msk-610/ReflowOven/doc/reflow_BOM.pdf

Num. | Ref | Value | Characteristics | Q'TY | Footprint | Vendor | Model Name
1 BZ1 | | UDB-05LFPN | Buzzer | 1 | 12x9.5RM7.6 | DB Products Limited. | UDB-05LFPN (https://akizukidenshi.com/catalog/g/gP-09704/)
2 C11 | | 0.01uF | 50V/B | 1 | 1608 | Murata | GRM188B11H103KA01 (https://akizukidenshi.com/catalog/g/gP-13387/)
3 C6,C8,C12,C13 | | 0.1uF | 50V/X8L | 4 | 1608 | Murata | GCM188L81H104K57 (https://akizukidenshi.com/catalog/g/gP-16143/)
4 C3 | | 1uF | 25V/X7R | 1 | 1608 | Murata | GRM188R71E105KA12 (https://akizukidenshi.com/catalog/g/gP-14526/)
5 C1,C9 | | 10uF | 16V/X5R | 2 | 1608 | Murata | GRM188R61C106KAAL (https://akizukidenshi.com/catalog/g/gP-17202/)
6 C4,C5,C10 | | 22uF | 25V/X5R | 3 | 2012 | Murata | GRM21BR61E226ME44 (https://akizukidenshi.com/catalog/g/gP-08240/)
7 C2,C7 | | 100uF/16V | 105℃ | 2 | Radial_D6.3mm_P2.50mm_H5.0mm | ルビコン | 16MH5100MEFC6.3X5 (https://akizukidenshi.com/catalog/g/gP-05002/)
8 D1 | | BAT43XV2 | Schottky Barrier Diode | 1 | SOD-523 | ON Semiconductor | BAT43XV2 (https://akizukidenshi.com/catalog/g/gI-06467/)
9 FB1,FB2,FB3,FB4 | | BLM18PG121SN1D | 120Ω/2A | 4 | 1608 | Murata | BLM18PG121SN1D (https://akizukidenshi.com/catalog/g/gP-10766/)
10 J1 | | S2B-PH-K-S | | 1 | S2B-PH-K | 日本圧着端子 | S2B-PH-K-S(LF)(SN) (https://akizukidenshi.com/catalog/g/gC-12633/)
11 J2 | | Conn_02x03 | PinHeader | 1 | 2x03_P2.54mm_Horizontal | Useconn Electronics Ltd. | PH-2x40RG (https://akizukidenshi.com/catalog/g/gC-00148/)
12 J3 | | S10B-PH-K-S | | 1 | S10B-PH-K | 日本圧着端子 | S10B-PH-K-S(LF)(SN) (https://www.sengoku.co.jp/mod/sgk_cart/detail.php?code=EEHD-55FJ)
13 J4 | | FH-1x14SG | PinSocket | 1 | 1x14_P2.54mm_Vertical | Useconn Electronics Ltd. | FH-1x14SG (https://akizukidenshi.com/catalog/g/gC-00653/)
14 J5 | | PCC_SMP | | 1 | PCC-SMP-K | オメガエンジニアリング | PCC-SMP-K-ROHS (https://akizukidenshi.com/catalog/g/gP-14972/)
15 Q1,Q2,Q3 | | AO3400A | Nch MOSFET | 3 | SOT-23 | Alpha & Omega Semiconductor | AO3400A (https://akizukidenshi.com/catalog/g/gI-14653/)
16 R13,R14 | | 0 | | 2 | 1608 | KOA | RK73Z1JTTD (https://akizukidenshi.com/catalog/g/gR-11619/)
17 R2,R5,R8,R10 | | 100 | +/-5% | 4 | 1608 | KOA | RK73B1JTTD101J (https://www.sengoku.co.jp/mod/sgk_cart/detail.php?code=EEHD-57FV)
18 R9 | | 270 | +/-5% | 1 | 1608 | KOA | RK73B1JTTD271J (https://www.sengoku.co.jp/mod/sgk_cart/detail.php?code=EEHD-57G5)
19 R1,R3,R4,R6,R11,R12,R19 | | 10k | +/-5% | 7 | 1608 | KOA | RK73B1JTTD103J (https://www.sengoku.co.jp/mod/sgk_cart/detail.php?code=EEHD-57GX)
20 SW1,SW3 | | SW_SPST_RA | Tact Switch (Right Angle) | 2 | 4.5mmx4.5mm | | eBay (https://www.ebay.com/itm/171414989246) or amazon (https://www.amazon.co.jp/dp/B084VP9CK2)
21 SW2 | | SW_SPST | Tact Switch | 1 | 3mmx4mm | Zhejiang Jianfu Electronics Co., Ltd | TVAF06-A020B-R (https://akizukidenshi.com/catalog/g/gP-14888/)
22 U1 | | AZ1117CH-3.3TRG1 | 3.3V/1.35A | 1 | SOT-223-3_TabPin2 | Diodes Incorporated. | AZ1117CH-3.3TRG1 (https://akizukidenshi.com/catalog/g/gI-16155/)
23 U2 | | ESP32-WROOM-32E | | 1 | ESP32-WROOM-32E | Espressif | ESP32-WROOM-32E-N16 (https://akizukidenshi.com/catalog/g/gM-15675/)
24 U3 | | MAX31855KASA | | 1 | SOIC-8_P1.27mm | Analog Devices(Maxim) | MAX31855KASA+
25 R15,R16,R17,R18,R20 | | 0NM | | 5 | 1608 No Mount | KOA | RK73Z1JTTD (https://akizukidenshi.com/catalog/g/gI-14486/)
26 R7 | | 100NM | | 1 | 1608 No Mount | KOA | RK73B1JTTD101J (https://www.sengoku.co.jp/mod/sgk_cart/detail.php?code=EEHD-57FV)
Num. | Ref | Value | Characteristics | Q'TY | Footprint | Vendor | Model Name
1 | | | | 1 | | Kuongshun Electronic Limited | MSP2807 (https://akizukidenshi.com/catalog/g/gM-16265/)
2 | | | | 1 | | | Ｋ型熱電対プローブ (https://akizukidenshi.com/catalog/g/gP-00306/)
3 | | | | 1 | | FOTEK CONTROLS., LTD | 25A SSR-25DA (https://akizukidenshi.com/catalog/g/gI-14017/)
4 | | | | 1 | | uxcell japan | rakuten (https://item.rakuten.co.jp/uxcelljapan/a16060300ux0245/)
5 | | | | 4 | | | 銅線用 圧着端子 丸形 M4ネジ用
6 | | | | 1 | | 日本圧着端子 | PHR-2 (https://akizukidenshi.com/catalog/g/gC-12795/)
7 | | | | 1 | | 日本圧着端子 | PHR-10 (https://www.sengoku.co.jp/mod/sgk_cart/detail.php?code=4DK2-SDD8)
8 | | | | 12 | | 日本圧着端子 | SPH-002T-P0.5L (https://akizukidenshi.com/catalog/g/gC-12809/)
9 | | | | 1 | | マル信 | MJ-077N (https://akizukidenshi.com/catalog/g/gC-06343/)
10 | | | | 4 | | | M3 約11mm 両メネジ スペーサー (https://store.shopping.yahoo.co.jp/sapporo-boueki/bps-0038.html)
11 | | | | 8 | | | M3×5mm　なべ頭ねじ

## http://github.com/msk-610
