msk-610/ReflowOven/doc/reflow_schematic.pdf

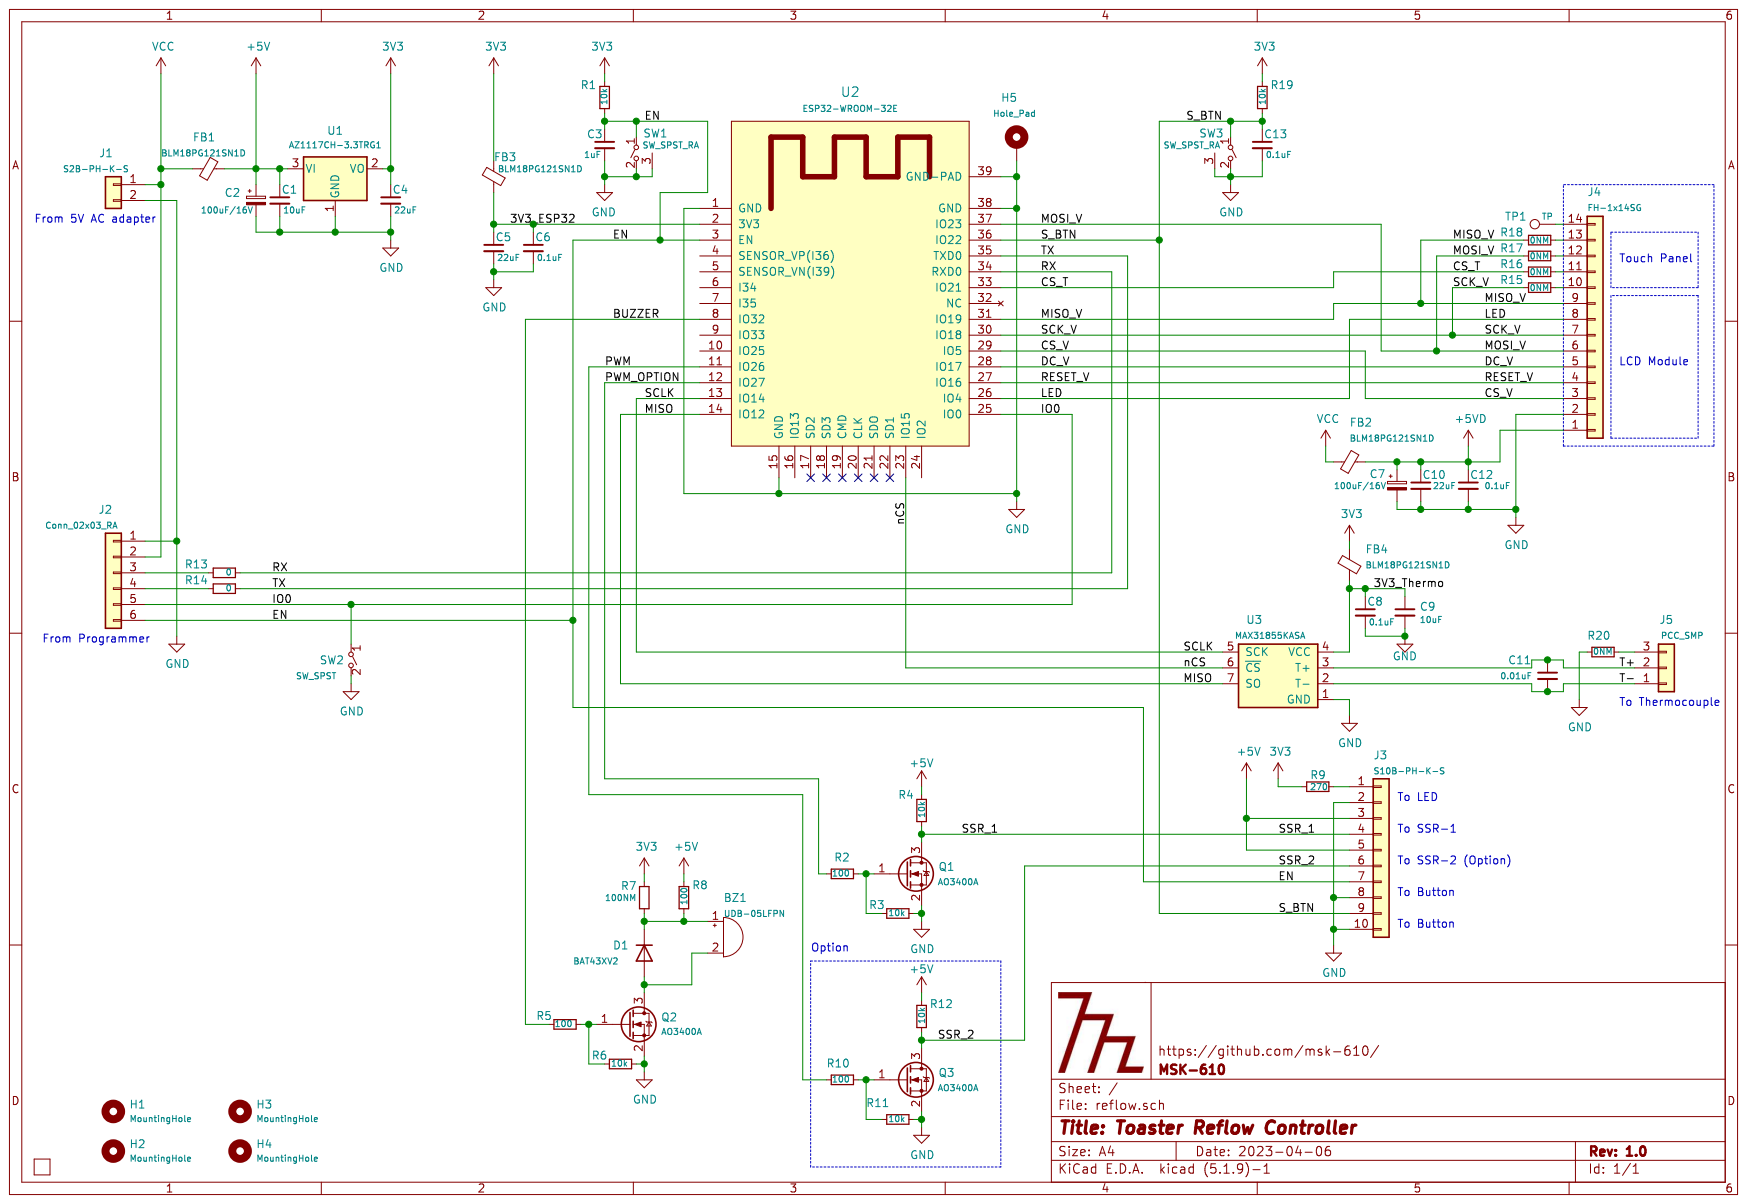
[picture p4: page 1]
